gadepall/pt100/codes/arduino/README.md

# Arduino Deployment Guide
This guide outlines the steps to compile the project using PlatformIO and upload the firmware to the Arduino board.  
## Prerequisites
PlatformIO: Ensure PlatformIO is installed to manage the project build.\
Arduino IDE: Required for the final upload step.\
Hardware: Arduino UNO connected to the computer via USB.  

Project Initialization

1. Create and initialize the project directory: 
```bash
mkdir pt100_project
cd pt100_project
pio project init --board uno
```
2. Install the required Arduino libraries for the LCD and ADC:  
```bash

pio lib install "LiquidCrystal"
pio lib install "Adafruit ADS1X15"
```
3. Compile the following code using the given command after you copy the code into **src/main.cpp** in the **pt100_project** folder.
```bash
pio run −t nobuild −t upload
```

## Code Guide
[Dataset Collection](https://github.com/gadepall/pt100/tree/main/codes/arduino/datacollection/code)\
[Inference of Temperature using Model](https://github.com/gadepall/pt100/tree/main/codes/arduino/inference/code)
