gadepall/pt100/AutoTrainer/img/README.md

# ALL IMAGES GO HERE 
---
All the captured thermometer readings and voltage readings go here
