gadepall/pt100/main.tex

\documentclass[conference]{IEEEtran}
\usepackage{gvv-book}
\usepackage{gvv}
%\IEEEoverridecommandlockouts
\usepackage{tabularx}
\usepackage{placeins}
\usepackage{cite}
%\usepackage{enumitem}
\usepackage{amsmath,amssymb,amsfonts}
\usepackage{graphicx}
\usepackage{textcomp}
\usepackage{xcolor}
\usepackage{makecell}
\usepackage{listings}
\usepackage{url}
\usepackage{xurl}
\usepackage{hyperref}
\usepackage{booktabs}
\usepackage{float}
\usepackage{balance}
%\usepackage{tcolorbox}

%\usepackage{minted}
%\usepackage{markdown}
%\usepackage[citations,hybrid]{markdown}

\definecolor{codegreen}{rgb}{0,0.6,0}
\definecolor{codegray}{rgb}{0.5,0.5,0.5}
\definecolor{codepurple}{rgb}{0.58,0,0.82}
\definecolor{backcolour}{rgb}{0.95,0.95,0.92}

\lstdefinestyle{mystyle}{
    backgroundcolor=\color{backcolour},
    commentstyle=\color{codegreen},
    keywordstyle=\color{magenta},
    numberstyle=\tiny\color{codegray},
    stringstyle=\color{codepurple},
    basicstyle=\ttfamily\footnotesize,
    breakatwhitespace=false,
    breaklines=true,
    captionpos=b,
    keepspaces=true,
    numbers=left,
    numbersep=5pt,
    showspaces=false,
    showstringspaces=false,
    tabsize=2
}
\lstset{style=mystyle}
\usetikzlibrary{arrows.meta, positioning, fit, backgrounds}
%\markdownSetup{
%  renderers = {
%    link = {\href{#3}{#1}}
%  }
%}

%\title{High-Precision Temperature Measurement for PT100: A Comparative Model Analysis}
\title{An AI Based High-Precision Industrial Thermometer}

\author{
    \IEEEauthorblockN{Puni Aditya, Vivek K. Kumar, Jnanesh Sathisha Karmar, Burra Shreyas Goud, G.V.V. Sharma}
    \IEEEauthorblockA{\textit{Department of Electrical Engineering} \\
    \textit{Indian Institute of Technology Hyderabad}\\
    Kandi, India \\
    gadepall@ee.iith.ac.in}
}

\begin{document}
\maketitle

% \begin{abstract}
	% In this paper, we design and develop an industrial thermometer using the PT100 temperature sensor.   This is done by 
% analyzing the suitability of five machine learning (ML) techniques: a quadratic/inverse quadratic Least Squares (LSQ) model, a Stochastic/inverse Stochastic Gradient Descent (SGD) trained model, and a non-linear Random Forest Regressor (RFR) by calibrating them with respect to a commercial pen thermometer.  The calibration process is also automated using Optical Character Recognition (OCR).
% Through numerical results, we conclude that the LSQ model is superior to the other models and implement it using the Arduino framework on an Arduino UNO. 
% \end{abstract}

% \begin{abstract}
% Accurate temperature measurement is critical in industrial process control. Platinum Resistance Temperature Detectors (RTDs), specifically the PT100, are widely utilized for their stability and linearity. However, traditional calibration requires expensive, specialized hardware. In this paper, we propose a cost-effective methodology for calibrating PT100 sensors using machine learning (ML) and computer vision. Our primary contribution is an Optical Character Recognition (OCR) based data acquisition pipeline that captures real-time analog thermometer readings and pairs them with sensor voltage outputs during a dynamic thermal cycle, eliminating the need for thermal chambers. Furthermore, we evaluate multiple ML techniques for non-linear calibration: physically-informed Least Squares (LSQ) regression, Stochastic Gradient Descent (SGD), and a Random Forest Regressor (RFR). Evaluated across a high-precision Wheatstone bridge with a 16-bit ADC, the physically-informed LSQ quadratic model achieves superior accuracy, yielding a Mean Squared Error (MSE) of 0.009198 and an $R^2$ of 0.999956, outperforming the generic regressors.
% \end{abstract}

\begin{abstract}
Measuring temperature accurately is necessary for many industrial processes. The PT100, a Platinum Resistance Temperature Detector (RTD), is preferred for this purpose for its stability and linearity. Its calibration traditionally requires expensive and dedicated hardware. In this paper, we design and develop a more cost-effective industrial thermometer. This is done by analysing the suitabilty of different machine learning (ML) techniques: two different types of quadratic Least Squares (LSQ) model, a Stochastic Gradient Descent (SGD) trained model and a non-linear Random Forest Regressor (RFR) by calibrating them with respect to a commercial pen thermometer. This calibration process is also automated by the use of Optical Character Recognition (OCR). Through numerical results, we conclude that the LSQ model is superior to other models and yields a Mean Squared Error (MSE) of 0.009198 and an $R^2$ of 0.999956. We then implement it using the Arduino framework on an Arduino UNO.
\end{abstract}

\begin{IEEEkeywords}
PT100, Machine Learning, Optical Character Recognition, Automated Training.
\end{IEEEkeywords}

% \section{Introduction}
% Temperature measurement is a fundamental requirement in process control, automotive systems, and instrumentation. Among the various contact temperature sensors available, the Platinum Resistance Temperature Detector (RTD), commonly known as the PT100, is considered the standard for precision thermometry \cite{rtd_theory}.
% The PT100, are widely favored in industrial applications for their linearity and stability. 
% \cite{paper4}
 % investigated the transient (dynamic) behavior of resistance temperature sensors using two experimental techniques: the Plunge Test and the Self-Heating Test. The goal was to identify the sensor's Transfer Function for use in real-time control systems.
 % Here, the focus  was only on the dynamic modeling (time delay/response) of the sensor, not the static (steady-state) calibration or non-linearity correction, which is critical for overall accuracy across a wide range. Futher, the above approach required specialised dynamic testing equipment.
% \cite{paper1} used an Artificial Neural Network (ANN) to non-linearly calibrate PT100 sensor readings across $-50\degree$C to $150\degree$C. 
% Achieved $>91\%$ accuracy improvement, reducing error from $\sim 1.3\degree$C to $\sim 0.27\degree$C.
% In \cite{paper3}, Multisim software was used for the simulation and design of the measurement transducer. 
 
% Both  the above  works were primarily based on software simulation only. They did not implement or compare against machine learning models, relying solely on theoretical circuit performance, leaving the real-time processing feasibility and computational overhead on embedded hardware unaddressed.
% To address the gap between expensive hardware calibration and superficial software simulations, this paper presents a novel framework for PT100 calibration. Our unique contributions go beyond simply combining standard circuitry with ML models. First, we propose an automated Optical Character Recognition (OCR) based dataset generation pipeline that synchronises analog readings with sensor voltages, completely circumventing the need for expensive calibration thermal chambers. Second, we present a comparative study evaluating ML models specifically constrained for low-power edge microcontrollers.

\section{Introduction}
Temperature measurement is a fundamental requirement in process control, automotive systems, and instrumentation. Among the various contact temperature sensors available, the Platinum Resistance Temperature Detector (RTD), commonly known as the PT100, is considered the standard for precision thermometry \cite{rtd_theory}. The PT100, are widely favored in industrial applications for their linearity and stability. \cite{paper2} implemented the circuit using dedicated differental amplifiers. They did not implement machine learning models, relying solely on circuit performance, leaving computational overhead on embedded hardware unaddressed. This needs specialised analog components and an expensive high-performance microcontroller. However, \cite{paper1} used an Artificial Neural Network (ANN) to non-linearly calibrate PT100 sensor readings across $-50 \degree$C to $150 \degree$C. Both the above works require expensive hardware testing for accurate dataset generation.

To address the gap between expensive hardware calibration and software simulations, this paper presents a novel framework for PT100 calibration. First, we propose an automated Optical Character Recognition (OCR) based dataset generation pipeline that synchronises analog readings with sensor voltages. Second, we present a comparative study evaluating various ML models to identify the most robust algorithm for steady-state non-linearity correction.

In the process, we detail the calibration and characterisation of a PT100 sensor by comparing two hardware signal conditioning setups: a simple voltage divider and a precision Wheatstone bridge interfaced with an ADS1115 ADC. We also automate the process of generating the dataset by using OCR to capture the readings of the analog thermometer through a mobile phone camera. The parameters for all the above ML techniques are finally hardcoded in the ATMEGA328P microcontroller, using the Arduino UNO board.

\section{PT-100 Fundamentals}
%\subsection{Fundamental Principles}
The PT100 is defined by a nominal resistance of $100\,\Omega$ at $0\degree$C. Unlike thermocouples which generate a voltage, RTDs differ in that they operate by changing electrical resistance in direct proportion to temperature changes \cite{sensor_physics}. This relationship is inherently non-linear over wide ranges, though it is highly predictable. The resistance $R(t)$ at temperature $t$ is governed by the Callendar-Van Dusen equation \cite{callendar_vd}
\begin{equation}
    R(t) = R_0 (1 + A t + B t^2)
\end{equation}
for temperatures $t > 0\degree$C, where $A$ and $B$ are standard coefficients. This quadratic physical relationship serves as the theoretical justification for using LSQ models in this work.

%\subsection{Measurement Challenges}
While PT100 sensors offer high stability, the resistance change is relatively small ($\approx 0.385\,\Omega/\degree$C). Consequently, accurate reading requires precise signal conditioning to convert resistance changes into measurable voltage levels \cite{wheatstone_ref}. This paper aims to optimise this conversion by analysing different hardware front-ends and software regression models to find an optimal solution for high-precision, low-cost temperature sensing.

\section{Hardware Setup}
Two main analog front-ends were tested to evaluate the trade-off between circuit complexity and measurement accuracy. \tabref{table:list_table} lists the components required for both analog front-ends, detailing the specific parts used for high-accuracy and cost-effective implementations. The detailed hardware component list, alongside the pin-connection configurations for the ADS1115 and LCD, are provided in Appendix \ref{app:Hardware} to facilitate reproducibility.
%
%
\begin{itemize}
    \item {\em High-Precision Wheatstone Bridge with ADC:} This uses a Wheatstone bridge configuration coupled with an external 16-bit ADS1115 ADC \cite{ads1115_datasheet}. This setup allows for differential measurement, significantly reducing noise and common-mode errors. 
	The connection details for integrating the external 16-bit ADS1115 ADC are  available in \tabref{table:ads1115_connections}. 
	The complete circuit schematic for the high-precision Wheatstone bridge setup is illustrated in \figref{fig:wheatstone_schematic}.

    \item {\em Simple Voltage Divider:} This uses a simple voltage divider utilising the Arduino's internal 10-bit ADC. 
	The complete circuit schematic for the simple voltage divider setup is illustrated in \figref{fig:voltage_divider_schematic}.

\end{itemize}

The Arduino-LCD connections are available in \tabref{table:lcd_connections}. 
The code for the Arduino, which reads the voltage across the PT-100 and displays it on the LCD, alongside flashing instructions, is provided in our repository\footnote{Arduino Data Collection Code: \url{https://github.com/gadepall/pt100/tree/main/codes/arduino/datacollection/code}}.

\section{Automated Training Using OCR}
%\markdownInput{AutoTrainer/README.md}
The dataset is collected by simulating a real-world thermal change (cooling cycle) to capture paired temperature readings. Since the training data is available only on an analog thermometer, instead of manually noting the temperature, we automate the data collection process using OCR based techniques. The block diagram for the same is shown in \figref{fig:setup}. 
Appendix \ref{app:AutoTrainer} has more information on the software execution.
\subsection{Experimental Setup}
The practical requirements and experimental setup are listed below
\begin{enumerate}
	\item {\em Hardware:}
\begin{itemize}
    \item The arduino setup with the code from the previous section flashed.
    \item A phone connected to your computer.
    \item {(Optional)} An NVIDIA GPU with CUDA installed. The script is pre-set to use \texttt{gpu=True} for much faster processing.
\end{itemize}
%
\item {\em Software:}
\begin{itemize}
    \item Python 3.x
    \item The required Python libraries: \texttt{opencv-python}, \texttt{easyocr}, and \texttt{numpy}.
\end{itemize}
\end{enumerate}

%\begin{figure}[H]
    % \centering
    % \includegraphics[width=\columnwidth]{figs/autotrainer_schematic.png}
    % \caption{Auto-Trainer representation}
    % \label{fig:autotrainer_schematic}
% \end{figure}
\begin{figure}[H]
\centering
\resizebox{\columnwidth}{!}{
\begin{tikzpicture}[
    font=\small,
    >=Stealth,
    node distance=0.75cm and 1.2cm,
    mainblock/.style={
        draw=black, fill=white,
        rectangle,
        minimum width=2.5cm,
        minimum height=1cm,
        line width=0.7pt,
        align=center
    },
    groupbox/.style={
        draw=black!70,
        dashed,
        rectangle,
        rounded corners=3pt,
        line width=0.65pt,
        inner sep=8pt
    },
    arrow/.style={->, line width=0.7pt},
    lblstyle/.style={
        font=\scriptsize\itshape,
        align=center
    }
]

%----- Column 1: Measurement Source -----
\node[mainblock] (hotwater) {Hot Water\\Container};
\node[mainblock, below=0.8cm of hotwater] (tempdevice) {Temperature Probe\\with Digital Display};

%----- Column 2: Image Capture (top) + Display Unit (bottom) -----
\node[mainblock, right=2.2cm of hotwater] (camera) {Smartphone\\Camera};
\node[mainblock, below=0.8cm of camera] (lcd) {LCD Voltage\\Display};

%----- Column 3: Processing & Output -----
\node[mainblock, right=2.0cm of camera] (ocr) {Computer\\(EasyOCR)};
\node[mainblock, below=0.8cm of ocr] (output) {Extracted\\Readings};

%----- Background Groups -----
\begin{scope}[on background layer]
  % Measurement Source box
  \node[groupbox,
        fit=(hotwater)(tempdevice),
        label={[font=\scriptsize\bfseries]above:Measurement Source}] (grp1) {};

  % Image Capture box (camera only, top half)
  \node[groupbox,
        fit=(camera),
        label={[font=\scriptsize\bfseries]above:Image Capture}] (grp2) {};

  % Display Unit box (lcd only, bottom half)
  \node[groupbox,
        fit=(lcd),
        label={[font=\scriptsize\bfseries]below:Display Unit}] (grp3) {};

  % Processing & Output box
  \node[groupbox,
        fit=(ocr)(output),
        label={[font=\scriptsize\bfseries]above:Processing \& Output}] (grp4) {};
\end{scope}

%----- Connections -----

% Hot Water -> Temperature Probe (downward, labelled "temperature")
\draw[arrow]
    (hotwater) --
    node[right, lblstyle]{temperature}
    (tempdevice);

% Temperature Probe -> Smartphone Camera (zig-zag: right, then up, avoiding LCD block)
\draw[arrow]
    (tempdevice.east) --
    node[below, lblstyle]{display}
    ++(1.5,0)
    |- (camera.west);

% LCD Voltage Display -> Smartphone Camera (upward)
\draw[arrow]
    (lcd.north) -- (camera.south);

% Smartphone Camera -> Computer/EasyOCR (rightward, labelled "video frames")
\draw[arrow]
    (camera) --
    node[above, lblstyle]{video\\frames}
    (ocr);

% Computer -> Extracted Readings (downward, labelled "parsed text")
\draw[arrow]
    (ocr) --
    node[right, lblstyle]{parsed\\text}
    (output);

\end{tikzpicture}
}
\caption{Block diagram of the experimental setup}
\label{fig:setup}
\end{figure}

\subsection{Data Collection Methodology}\label{data-collection-methodology}
\begin{enumerate}
    \item {Setup:} Place both the PT100 probe and the reference thermometer inside an electric kettle, submerged in water.
    \item {Heating Phase:} Turn on the kettle and heat the water to its boiling point.
    \item {Recording Phase:} 
    \begin{itemize}
        \item Switch off the kettle at boiling point.
        \item Start recording a {video} using the smartphone.
        \item Ensure {both the PT100 LCD display} and {reference thermometer} are visible in the frame.
    \end{itemize}
    \item {Cooling Phase:} Continue recording the cooling process as the water temperature drops naturally.
    \item {Data Extraction:} The recorded video acts as the raw dataset.
%    \begin{itemize}
        \item Extract frames and apply OCR to detect readings from both displays.
%    \end{itemize}
\end{enumerate}

\section{Machine Learning Models}

\subsection{Model Explanations}
The LSQ and SGD models obtained from the dataset derived in the previous section are available in 
    \tabref{tab:model_coefficients}.
	The coefficients are determined through linear least squares regression.  
\begin{table}[h!]
    \centering
	\caption{Extracted Polynomial Coefficients for Forward and Inverse Regression Models. (Note: $X$ represents sensor voltage in Volts, and $Y$ represents Temperature in $^\circ$C)}
	\renewcommand{\arraystretch}{1.3} 
    % \resizebox{\columnwidth}{!}{...} ensures the table fits exactly within the single column
    \resizebox{\columnwidth}{!}{%
    \begin{tabular}{|l|l|c|c|c|p{4.5cm}|}
        \hline
        \textbf{Model} & \textbf{Equation} & \textbf{$a$} & \textbf{$b$} & \textbf{$c$} & \textbf{Description} \\
        \hline
        Inverse LSQ (No ADC) & 
        $X = aY^2 + bY + c$ & 
        $-0.000014990$ & 
        $0.005589496$ & 
        $2.526066163$ & 
        Inverse Least Squares with voltage divider setup without ADC. \\
        \hline
        Inverse LSQ (ADC) & 
        $X = aY^2 + bY + c$ & 
        $-0.000006744$ & 
        $0.004344843$ & 
        $0.056019368$ & 
        Inverse Least Squares with ADC setup and Wheatstone bridge. \\
        \hline
        Quadratic LSQ (ADC) & 
        $Y = aX^2 + bX + c$ & 
        $147.376208110$ & 
        $197.568472526$ & 
        $-10.357480491$ & 
        Least Squares (Quadratic) for Wheatstone bridge with ADC. \\
        \hline
        SGD & 
        $Y = aX^2 + bX + c$ & 
        $190.226107678$ & 
        $173.380527679$ & 
        $-7.072446221$ & 
        Stochastic Gradient Descent model fit. \\
        \hline
        Inverse SGD & 
        $X = aY^2 + bY + c$ & 
        $-0.000005386$ & 
        $0.004183549$ & 
        $0.060452454$ & 
        Inverse Stochastic Gradient Descent model fit. \\
        \hline
    \end{tabular}%
    }
    \vspace{0.2cm}
    
    \footnotesize
    \raggedright
    \label{tab:model_coefficients}
\end{table}

\begin{enumerate}
    \item \textbf{Least Squares (LSQ) and Inverse LSQ Regression:} 	The Callendar-Van Dusen equation gives the relationship between the temperature and resistance. This by extension gives us the relation $Y = aX^2 + bX + c$, which we call \textit{LSQ} model. We also define another model $X = aY^2 + bY + c$, which we refer to as \textit{Inverse LSQ} model. The coefficients for both these models are found by applying the least square regression utilising the data obtained using the Optical Character Recognition. The \textit{Inverse LSQ} was also chosen to be quadratic to obtain more accuracy.
    
    \item \textbf{Stochastic Gradient Descent (SGD) Regressor:} SGD is an optimisation technique used for approximation of continuous values \cite{SGD}. Instead of analysing the complete dataset, it generates a model based on a small set of that data and then updates the model as it processes the next subset. This method is preferred over other optimisation techniques because of its real-time processing and efficiency.
    
    \item \textbf{Random Forest Regressor (RFR):} RFR is a machine learning algorithm that predicts values using decision trees \cite{RFR}. The training of the model is done by giving it a large dataset to form the decision tees. Because it uses data trees, the values outside the range of dataset cannot be predicted. But this model is included to check if the interpolation of data can give a better model of measurement of temperature than the standard machine learning models.
\end{enumerate}

The models are obtained and implemented using Python and the scikit-learn\cite{scikit-learn} library.
The implementation of these models and the evaluation of Mean Squared Error (MSE) and R-squared ($R^2$) metrics are available in the repository\footnote{Model Implementation: \url{https://github.com/gadepall/pt100/blob/main/codes/models/PT100_models.ipynb}}.

\section{Model Evaluation and Comparison}

\tabref{tab:model_performance} summarises the Mean Squared Error (MSE) and R-squared ($R^2$) values for all the implemented models \cite{MSER2}. 
MSE was specifically selected to heavily penalise larger temperature prediction deviations—a critical safety requirement in industrial control systems. Conversely, the $R^2$ metric is utilised to measure the proportion of variance in the actual temperature that is predictably explained by the sensor's input voltage. A robust industrial thermometer must achieve an MSE approaching zero and an $R^2$ approaching 1.0. 
Based on these metrics, the LSQ (Quadratic) model for the Wheatstone bridge with ADC vastly outperforms the rest.
    \begin{table}[H]
    \centering
	\caption{Low MSE and high $R^2$ is desirable}
    \label{tab:model_performance}
    % |X|c|c| -> First column wraps text, others are centered
    \begin{tabularx}{\columnwidth}{|X|c|c|} 
        \hline
        \textbf{Model} & \textbf{MSE} & \textbf{$R^2$} \\
        \hline
        1. Inverse LSQ (Volt. Div w/o ADC) & 0.6612 & 0.9977 \\
        \hline
        2. Inverse LSQ (Wheatstone w/ ADC) & 0.016221 & 0.999922 \\
        \hline
        3. LSQ (Wheatstone w/ ADC) & 0.009198 & 0.999956 \\
        \hline
        4. SGD Regressor (Wheatstone w/ ADC) & 0.030477 & 0.999854 \\
        \hline
        5. Inverse SGD (Wheatstone w/ ADC) & 0.016221 & 0.999922 \\
        \hline
        6. Random Forest (Wheatstone w/ ADC) & 1.161318 & 0.994451 \\
        \hline
    \end{tabularx}
\end{table}

\iffalse
The below table presents a small subset of test data, showing the actual and predicted temperature values for the Voltage Divider setup.

\begin{table}[h!]
\centering
\caption{Voltage Divider Validation Table with Predictions}
\label{tab:voltage_divider_validation_predictions}
\begin{tabular}{|l|c|c|}
\hline
Voltage & Actual Temperature & Prediction \\
\hline
2.7300 & 39.7 & 40.9900 \\
2.7500 & 46.4 & 45.6500 \\
2.8400 & 68.3 & 68.8900 \\
2.8920 & 85.6 & 84.7100 \\
2.9100 & 90.0 & 90.8000 \\
2.8700 & 77.8 & 77.7400 \\
\hline
\end{tabular}
\end{table}
\fi

\tabref{tab:validation_data_subset}
presents a small subset of the test data, showing the actual temperature values alongside the predictions from the Random Forest, Inverse LSQ, LSQ, SGD, and Inverse SGD Regressor models for the Wheatstone bridge setup with ADC.
The corresponding graph is available in 
\figref{fig:wheatstone_model_comparison}.
%
We thus conclude that the LSQ model is best at predicting the temperature.  Though the results are provided only for a small range of temperatures in 
\tabref{tab:validation_data_subset}
and
\figref{fig:wheatstone_model_comparison}
for brevity and visualisation respectively,  the results hold true for all values of practical interest.
\begin{table}[H]
\centering
\caption{Wheatstone Validation Data and Predictions}
\label{tab:validation_data_subset}
\resizebox{\linewidth}{!}{%
\begin{tabular}{|c|c|c|c|c|c|c|}
\hline
\textbf{Volt} & \textbf{Actual} & \textbf{Inv LSQ} & \textbf{LSQ} & \textbf{SGD} & \textbf{Inv SGD} & \textbf{RF} \\
(V) & ($^\circ$C) & (ADC) & (ADC) & (ADC) & (ADC) & (ADC) \\
\hline
0.2634 & 51.9 & 51.9136 & 51.9070 & 51.7938 & 51.9906 & 53.3456 \\
0.3127 & 65.9 & 65.7972 & 65.8329 & 65.7442 & 65.8829 & 67.6248 \\
0.2083 & 37.2 & 37.1962 & 37.1906 & 37.2964 & 37.1134 & 37.0563 \\
0.4037 & 93.1 & 93.6290 & 93.4194 & 93.9231 & 93.2383 & 89.0505 \\
0.2092 & 37.5 & 37.4305 & 37.4238 & 37.5239 & 37.3513 & 37.0563 \\
0.2978 & 61.6 & 61.5231 & 61.5485 & 61.4304 & 61.6219 & 61.8901 \\
0.2028 & 35.8 & 35.7687 & 35.7707 & 35.9127 & 35.6628 & 36.7501 \\
0.2666 & 52.7 & 52.7931 & 52.7892 & 52.6712 & 52.8748 & 53.3456 \\
0.3185 & 67.5 & 67.4803 & 67.5183 & 67.4462 & 67.5568 & 68.7954 \\
0.2850 & 57.9 & 57.9067 & 57.9202 & 57.7921 & 58.0053 & 58.6497 \\
\hline
\end{tabular}
}
\end{table}
%\subsection{Graphical Comparison of Wheatstone ADC Models}
\begin{figure}[H]
    \centering
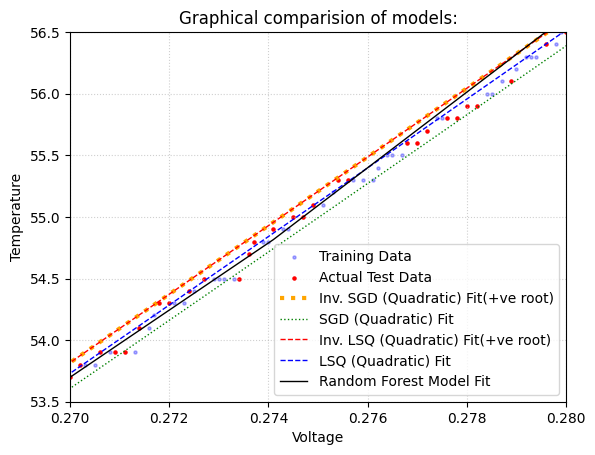
[picture p1: figs/combined_model_plot.png]
    
    \caption{Comparison of Random Forest, Inverse LSQ, LSQ, SGD and Inverse SGD Regressor predictions against actual test data for the Wheatstone bridge with ADC for temperatures between $53.5\degree$C to $56.5\degree$C}
    \label{fig:wheatstone_model_comparison}
\end{figure}

The code for the Arduino, which predicts the temperature from the voltage and flashing instructions are available in the repository\footnote{Temperature Prediction: \url{https://github.com/gadepall/pt100/tree/main/codes/arduino/inference/code}}.

\appendices

\section{Hardware Configuration and Schematics}
\label{app:Hardware}

\begin{table}[H]
\centering
\caption{Component List}
\label{table:list_table}
\begin{tabular}{|l|c|p{4cm}|}
    \hline
    \textbf{Component} & \textbf{Qty.} & \textbf{Description} \\
    \hline
    Arduino Uno & 1 & Microcontroller for processing and control. \\
    \hline
    ADS1115 ADC & 1 & 16-bit external ADC for high-precision voltage measurement. \\
    \hline
    PT100 RTD Sensor & 1 & Platinum resistance thermometer. \\
    \hline
    100$\Omega$ Resistor & 1 & Precision resistor for Wheatstone bridge. \\
    \hline
    4k$\Omega$ Resistors & 2 & Resistors for Wheatstone bridge. \\
    \hline
    JHD 162A Parallel LCD & 1 & For displaying the final temperature. \\
    \hline
    22k$\Omega$ Potentiometer & 1 & To adjust the contrast of the LCD. \\
    \hline
    Breadboard & 1 & For creating solderless circuit connections. \\
    \hline
    Jumper Wires & Set & For connecting all the components. \\
    \hline
    \makecell{Pen Thermometer \\ $<=0.1^\circ$C resolution} & 1 & Used for training purpose and as a reference. \\
    \hline
    Kettle/Heater with water & 1 & To heat the water, so that training data corresponding to a wide range of temperatures can be obtained\\
    \hline
\end{tabular}
\end{table}

\begin{table}[H]
\centering
\caption{ADS1115 Connections}
\label{table:ads1115_connections}
\resizebox{\columnwidth}{!}{%
\begin{tabular}{|c|c|l|}
    \hline
    \textbf{ADS1115 Pin} & \textbf{Arduino Pin} & \textbf{Purpose} \\
    \hline
    VDD & 5V & Power Supply \\
    \hline
    GND & GND & Common Ground \\
    \hline
    SCL & A5 (SCL) & I2C Clock Line \\
    \hline
    SDA & A4 (SDA) & I2C Data Line \\
    \hline
    A0 & \makecell{Input from Voltage Divider Node \\ (between PT100 and R\_REF)} &  Reading Voltage\\
    \hline
    A1 & \makecell{Junction between the two \\4k$\Omega$ resistors} & \makecell{Reference for \\differential reading} \\
    \hline
\end{tabular}
}
\end{table}

\begin{table}[H]
\centering
\caption{LCD Connections}
\label{table:lcd_connections}
\resizebox{0.6\columnwidth}{!}{%
\begin{tabular}{|c|c|}
    \hline
    \textbf{LCD Pin} & \textbf{Arduino Pin} \\
    \hline
    VSS & GND \\
    \hline
    VDD & 5V \\
    \hline
    V0 & Potentiometer Middle Pin \\
    \hline
    RS & Digital 12 \\
    \hline
    RW & GND \\
    \hline
    E & Digital 11 \\
    \hline
    D4 & Digital 5 \\
    \hline
    D5 & Digital 4 \\
    \hline
    D6 & Digital 3 \\
    \hline
    D7 & Digital 2 \\
    \hline
    A (Anode) & 5V \\
    \hline
    K (Cathode) & GND \\
    \hline
\end{tabular}
}
\end{table}

\begin{figure}[h!]
    \centering
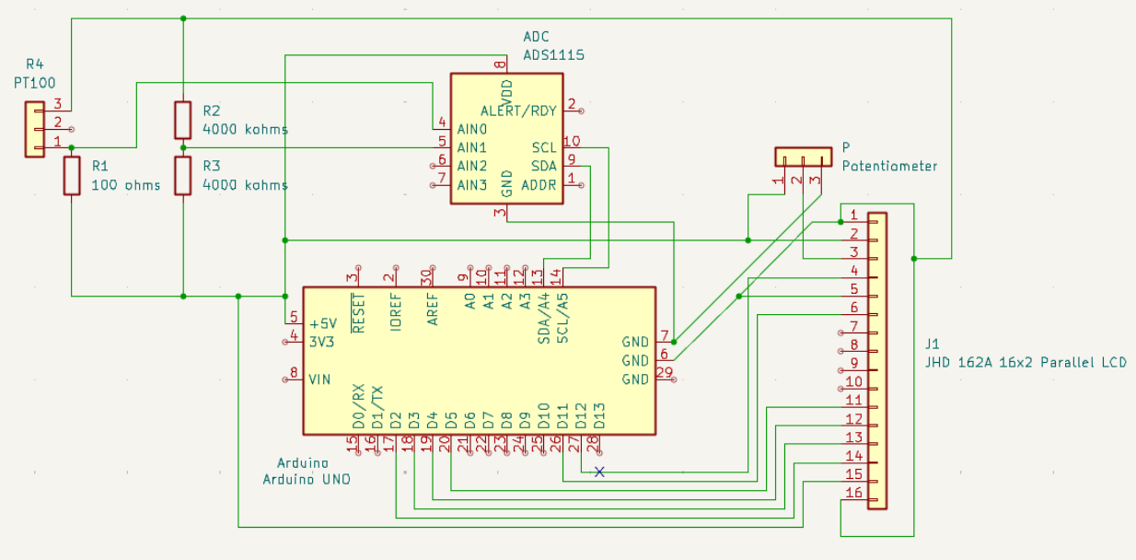
[picture p2: figs/circuit_schematic.png]
    
    \caption{Circuit Schematic of the High-Precision Wheatstone Bridge}
    \label{fig:wheatstone_schematic}
\end{figure}

\begin{figure}[h!]
    \centering
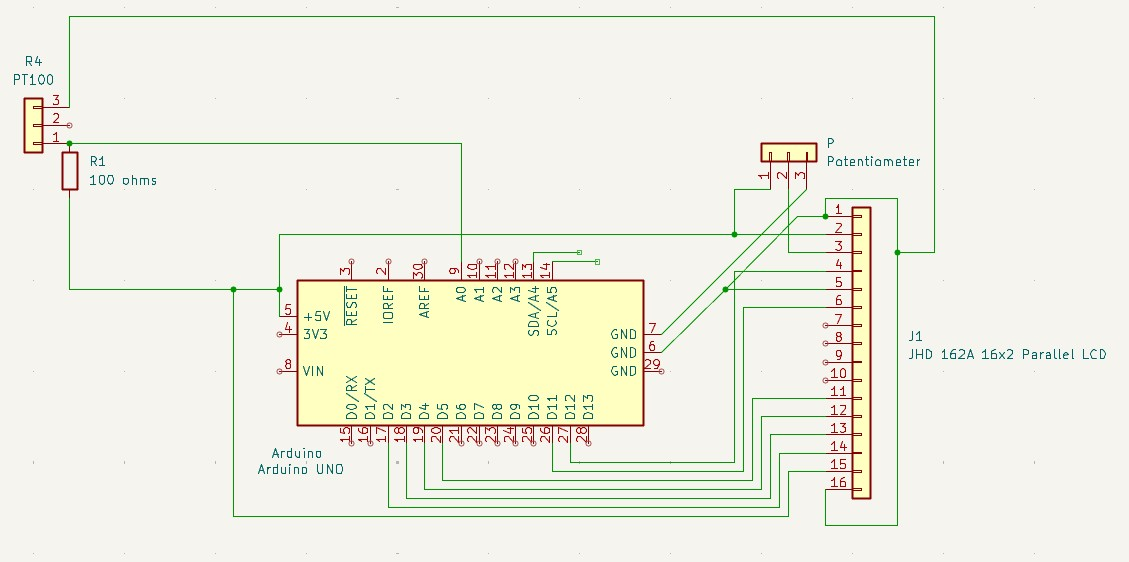
[picture p3: figs/circuit_schematic_2.jpg]
    
    \caption{Circuit Schematic of the simple voltage divider}
    \label{fig:voltage_divider_schematic}
\end{figure}

\section{Automated OCR Training Pipeline Setup}
\label{app:AutoTrainer}

\subsection{Pipeline Architecture and Data Logging}
The automated data acquisition pipeline was developed using Python. To capture the real-world thermal cycle, a smartphone camera was interfaced with a computer via DroidCam and OBS Studio, providing a continuous video feed of both the analog reference thermometer and the sensor's LCD display. The text extraction was handled using the \texttt{easyocr} \cite{easyocr} library, which relies on PyTorch \cite{pytorch} for deep learning-based inference, accelerated via an NVIDIA GPU. 

During the cooling phase of the thermal cycle, the script continuously monitored the video feed. Every 15 frames, if text was successfully detected in both regions, the script synchronised the readings and logged them into a structured dataset, formatted as paired voltage and temperature values. To facilitate manual debugging, the isolated bounding boxes of the digits were saved as individual image frames. Because the OCR engine is susceptible to occasional character misclassification, the generated dataset (\texttt{out.txt}) was manually reviewed and corrected to produce the final high-fidelity training dataset.

\subsection{Image Processing and Region of Interest (ROI) Calibration}
To achieve high OCR accuracy, the raw video frames required specific preprocessing and spatial cropping. The camera feed was divided into distinct Regions of Interest (ROIs): the voltage display was isolated from the top half of the frame, while the physical thermometer was isolated from the bottom-left third. 

Because the analog thermometer display was highly sensitive to ambient lighting, standard grayscaling was insufficient for reliable digit extraction. Therefore, an inverse binary thresholding operation was applied (with a threshold value of 130) to separate the liquid crystal digits from the background. To reconstruct broken segments within the digital numbers, a morphological closing operation was executed utilising an $11 \times 11$ rectangular structuring element. Finally, a $17 \times 17$ Gaussian blur was applied to the inverted mask to smooth the edges of the characters, significantly reducing background noise before the frames were passed to the \texttt{easyocr} engine. The further information regarding the installation and setup is provided in \fbox{\parbox{\linewidth}{\url{https://github.com/gadepall/pt100/tree/main/AutoTrainer}
}}.

%\item {Voltage:} In this case, the cropped voltage frame is converted to grayscale before it is used for OCR. Make sure the voltage reading is visible in the voltage frame. It is also preferred to hide the decimal point, either physically or by further image processing.
%\end{itemize}

\bibliographystyle{IEEEtran}
\bibliography{references}

\end{document}
