gadepall/pt100/tables/lsq_coefficients_table.tex

\begin{table}[H]
\centering
\caption{Coefficients for $V = AT^2 + BT + C$ Model}
\label{table:lsq_coefficients_table}
\begin{tabular}{lrrrr}
\toprule
 Method & A & B & C & $R^2$ Score \\
\midrule
 Voltage Divider & -1.0801e-05 & 0.004978 & 2.546675 & 0.9521 \\
 Wheatstone + ADC & 3.6118e-06 & 0.003880 & 0.099950 & 0.9997 \\
\bottomrule
\end{tabular}
\end{table}
