gadepall/pt100/tables/voltage_divider_training_table.tex

\begin{table}[H]
\centering
\caption{Voltage Divider Training Data (70\%)}
\label{table:voltage_divider_training_table}
\begin{tabular}{rr}
\toprule
 Temperature C & Voltage V \\
\midrule
 96.5 & 2.930 \\
 36.1 & 2.710 \\
 89.5 & 2.900 \\
 76.3 & 2.860 \\
 50.8 & 2.770 \\
 61.8 & 2.820 \\
 43.0 & 2.740 \\
 71.3 & 2.850 \\
 91.2 & 2.920 \\
 85.0 & 2.890 \\
 82.2 & 2.880 \\
 56.3 & 2.790 \\
 28.9 & 2.670 \\
\bottomrule
\end{tabular}
\end{table}
