gadepall/pt100/tables/wheatstone_training_table.tex

\begin{table}[H]
\centering
\caption{Sample of Wheatstone Bridge Training Data}
\label{table:wheatstone_training_table}
\begin{tabular}{rr}
\toprule
 Voltage V & Temperature C \\
\midrule
 0.2460 & 48.0 \\
 0.3704 & 82.9 \\
 0.1448 & 30.4 \\
 0.3121 & 65.8 \\
 0.3403 & 74.0 \\
 0.2646 & 52.5 \\
 0.2100 & 38.2 \\
 0.3777 & 85.1 \\
 0.3015 & 62.3 \\
 0.2223 & 41.9 \\
 0.1600 & 31.4 \\
 0.3169 & 66.7 \\
 0.1805 & 33.0 \\
 0.2641 & 52.4 \\
 0.2311 & 43.7 \\
\bottomrule
\end{tabular}
\end{table}
