gadepall/pt100/figs/autotrainer_schematic.png

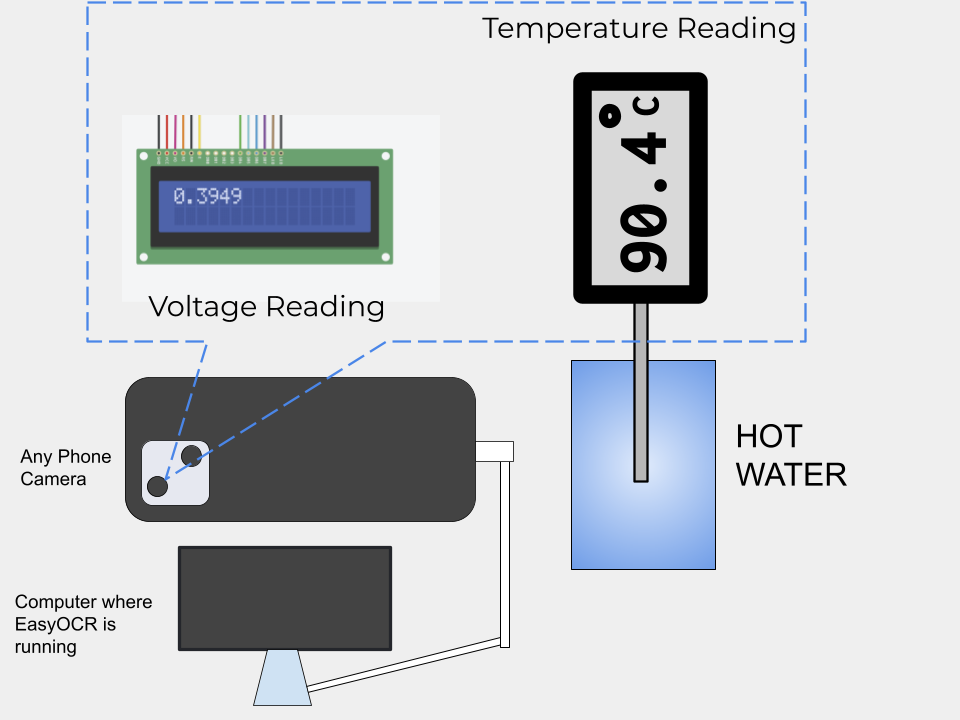
figs/autotrainer_schematic.png
