gadepall/pt100/figs/fig.jpg

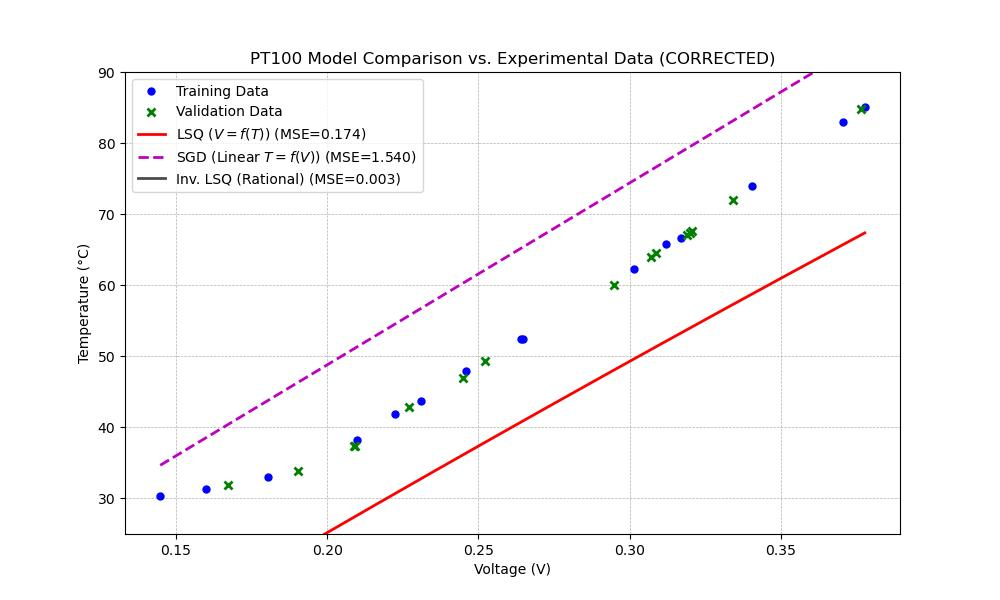
figs/fig.jpg
