gadepall/pt100/figs/wheatstone_model_comparison.png

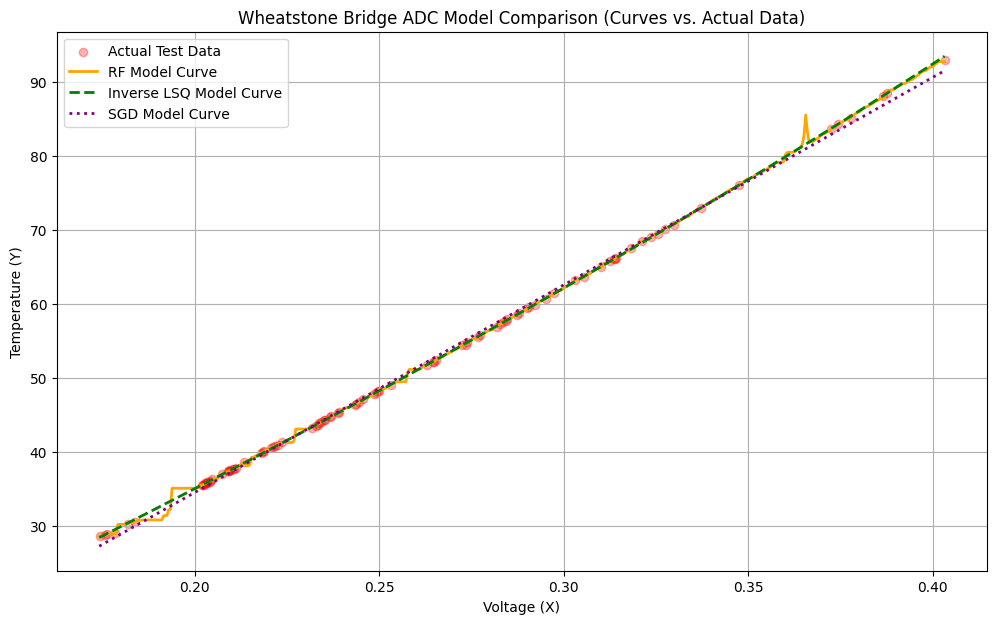
figs/wheatstone_model_comparison.png
