gadepall/pt100/tables/voltage_divider_validation_table.tex

\begin{table}[H]
\centering
\caption{Voltage Divider Validation Data (30\%)}
\label{table:voltage_divider_validation_table}
\begin{tabular}{rr}
\toprule
 Temperature C & Voltage V \\
\midrule
 39.7 & 2.730 \\
 46.4 & 2.750 \\
 68.3 & 2.840 \\
 85.6 & 2.892 \\
 90.0 & 2.910 \\
 77.8 & 2.870 \\
\bottomrule
\end{tabular}
\end{table}
