gadepall/pt100/tables/wheatstone_validation_accuracy_table.tex

\begin{table}[H]
\centering
\caption{Model Accuracy on Wheatstone Validation Set}
\label{table:wheatstone_validation_accuracy_table}
\begin{tabular}{lr}
\toprule
 Model & Mean Squared Error (MSE) \\
\midrule
 LSQ ($V=f(T)$) & 0.174116 \\
 SGD (Linear $T=f(V)$) & 1.540447 \\
 Inverse LSQ (Rational $V=f(T)$) & 0.003024 \\
\bottomrule
\end{tabular}
\end{table}
