gadepall/pt100/tables/wheatstone_validation_comparison.tex

\begin{table}[H]
\centering
\caption{Sample of Validation Data vs. Model Predictions}
\label{table:wheatstone_validation_comparison}
\begin{tabular}{rrrrr}
\toprule
 V (Actual) & T (Actual) & T (LSQ) & T (SGD-Linear) & T (Inv. LSQ) \\
\midrule
 0.2520 & 49.4000 & 49.4300 & 62.0526 & 49.4005 \\
 0.3188 & 67.1000 & 67.1235 & 79.2818 & 67.1003 \\
 0.2088 & 37.4000 & 37.3820 & 51.0117 & 37.4003 \\
 0.1673 & 31.9000 & 31.8315 & 40.2415 & 31.9000 \\
 0.2272 & 42.9000 & 42.9234 & 55.6200 & 42.9002 \\
 0.3207 & 67.7000 & 67.6534 & 79.7711 & 67.7001 \\
 0.3764 & 84.8000 & 84.7702 & 94.1311 
& 84.8000 \\
 0.2091 & 37.4000 & 37.4646 & 51.0885 & 37.4003 \\
 0.3069 & 64.0000 & 64.0416 & 76.2307 & 64.0002 \\
 0.3341 & 72.0000 & 72.0163 & 83.1970 & 72.0000 \\
 0.2949 & 60.1000 & 60.1417 & 73.1326 & 60.1002 \\
 0.2450 & 46.9000 & 46.9158 & 60.2505 & 46.9004 \\
 0.3200 & 67.4000 & 67.4721 & 79.5936 & 67.4002 \\
 0.3087 & 64.6000 & 64.5824 & 76.6749 & 64.6002 \\
 0.1905 & 33.9000 & 33.8642 & 46.1245 & 33.9001 \\
\bottomrule
\end{tabular}
\end{table}
