gadepall/pt100/(commit log)

2025-11-25 Added auto-trainer schematic diagram
2025-11-27 added survey and voltage_divider circuit
2025-12-13 Minor fixes to arduino deployment part
2026-01-31 readme.md for arduino modified
2026-05-19 Revise README for clarity and updated instructions
    Updated the README to reflect changes in the script's functionality and installation instructions, including new sections on dataset collection and calibration requirements.
